0V3RG4M3/epic-game-2025/egj-gamepacks-2025/production/BOM_JLCPCB.csv

Comment | Designator | Footprint | LCSC Part #
10u | C1,C6,C20,C24 | C_0805_2012Metric | C15850
100n | C2,C9,C12,C13,C14,C15,C16,C17,C18,C19,C21,C22,C33 | C_0402_1005Metric | C1525
15p | C4,C5 | C_0402_1005Metric | C1548
4.7u | C7,C8 | C_0402_1005Metric_small_pads | C23733
4.7u | C10,C11 | C_0402_1005Metric | C23733
100n | C25,C28,C32 | C_0805_2012Metric | C49678
1u | C26,C27,C30 | C_0805_2012Metric | C28323
4.7u | C29 | C_0805_2012Metric | C1779
120n | C31 | C_0805_2012Metric | C113854
1u | C34,C35 | C_0402_1005Metric | C52923
USB_B_Micro | J1 | USB_Micro-B_Amphenol_10103594-0001LF_Horizontal | C428495
BM03B-SRSS-TB | J3 | JST_SH_BM03B-SRSS-TB_1x03-1MP_P1.00mm_Vertical | C160389
AOTA-B201610S3R3-101-T | L1 | L_pol_2016 | C42411119
0 | R2 | R_0402_1005Metric | C17168
1k | R6,R7,R9 | R_0402_1005Metric | C11702
33 | R8,R15,R16 | R_0402_1005Metric | C25105
27 | R10,R11 | R_0402_1005Metric | C25100
10k | R12 | R_0402_1005Metric | C25744
10K | R13,R14,R20,R22 | R_0402_1005Metric | C25744
47K | R17,R18 | R_0402_1005Metric | C25792
4.7K | R19,R21 | R_0402_1005Metric | C25900
100k | R23,R24 | R_0402_1005Metric | C25741
180K | R25 | R_0402_1005Metric | C25760
100K | R26 | R_0402_1005Metric | C25741
PTS810SJG250SMTRLFS | SW1,SW2 | SW_SPST_PTS810 | C221895
W25Q128JVSIQ | U1 | SOIC-8_5.3x5.3mm_P1.27mm | C97521
NCP1117-3.3_SOT223 | U3 | SOT-223-3_TabPin2 | C26537
RP2350_80QFN | U4 | RP2350-QFN-80-1EP_10x10_P0.4mm_EP3.4x3.4mm_ThermalVias | C42415655
USBLC6-2P6 | U5 | SOT-666 | C15999
TPD6E05U06RVZR | U6,U7,U8,U9,U10 | DFN-14_1.35x3.5mm_P0.5mm | C962978
VL6180V1NR/1 | U11 | LGA12R75P2X6_280X480X110 | C2655167
TXS0108EPW | U12 | TSSOP-20_4.4x6.5mm_P0.65mm | C17206
XC6206P282MR | U13 | SOT-23-3 | C347374
BNO055 | U14 | LGA-28_5.2x3.8mm_P0.5mm | C93216
TPS2116DRL | U15 | SOT-583-8 | C3235557
ABM8-272-T3 | Y1 | Crystal_SMD_3225-4Pin_3.2x2.5mm | C20625731
