0V3RG4M3/epic-game-2025/egj-gamepacks-2025/SP3012-06UTG/SP3012-06UTG.step

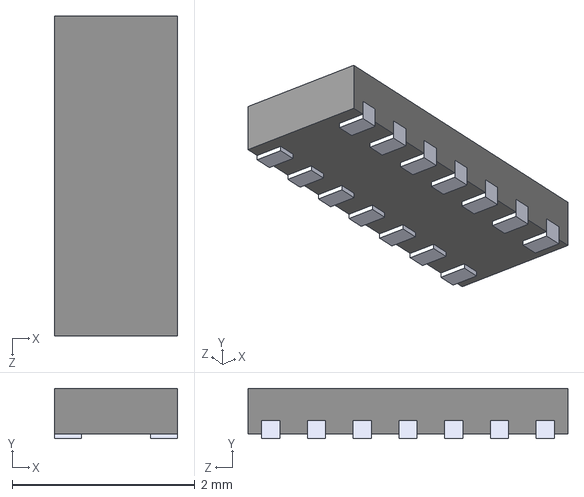
[picture p1: CAD file, 2025-04-10]
egj-gamepacks-2025/SP3012-06UTG/SP3012-06UTG.step
1.35 x 0.55 x 3.50 mm
