0V3RG4M3/epic-game-2025/egj-gamepacks-2025/VL6180XV0NR_1/VL6180XV0NR_1.step

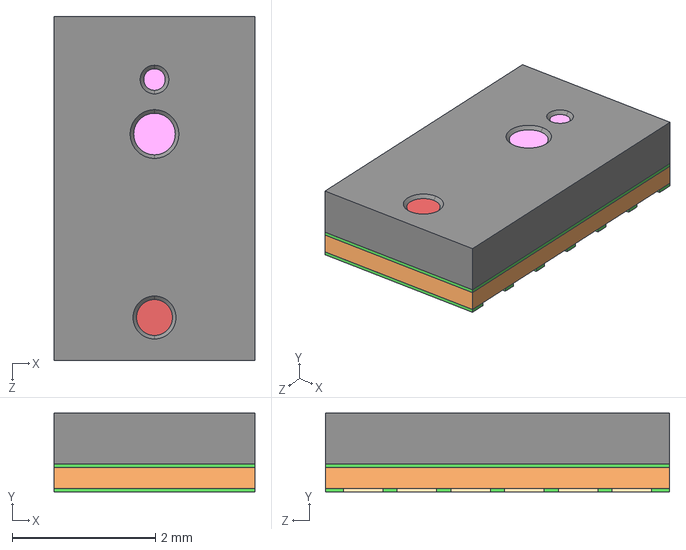
[picture p2: CAD file, 2025-04-21]
egj-gamepacks-2025/VL6180XV0NR_1/VL6180XV0NR_1.step
2.80 x 1.10 x 4.80 mm
