0V3RG4M3/epic-game-2025/egj-gamepacks-2025/egj-gamepacks-2025.kicad_pcb

## KiCad design egj-gamepacks-2025/egj-gamepacks-2025.kicad_pcb (2026-10-23)

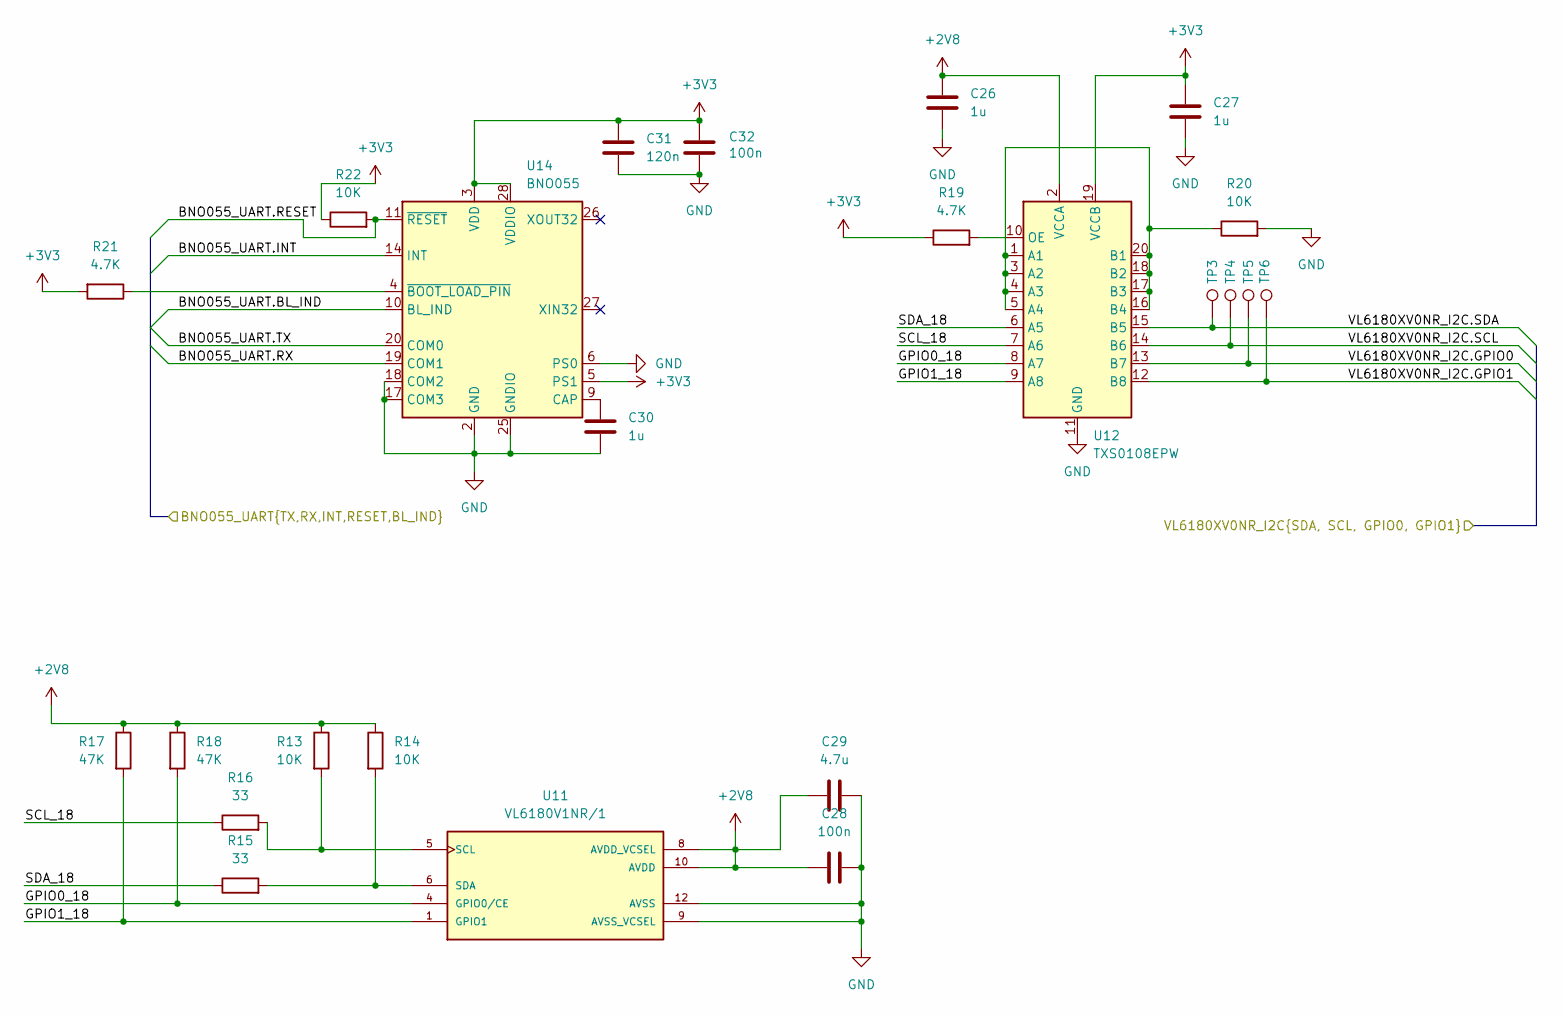
[picture p8: schematic untitled.kicad_sch]

Parts:
C26, C27, C30: 1u; C_0805_2012Metric; LCSC C28323
C28, C32: 100n; C_0805_2012Metric; LCSC C49678
C29: 4.7u; C_0805_2012Metric; LCSC C1779
C31: 120n; C_0805_2012Metric; LCSC C113854
R13, R14, R20, R22: 10K; R_0402_1005Metric; LCSC C25744
R15, R16: 33; R_0402_1005Metric; LCSC C25105
R17, R18: 47K; R_0402_1005Metric; LCSC C25792
R19, R21: 4.7K; R_0402_1005Metric; LCSC C25900
TP3, TP4, TP5, TP6: TestPoint; TestPoint_Keystone_5015_Micro_Mini; LCSC C2906768
U11: VL6180V1NR/1; LGA12R75P2X6_280X480X110; LCSC C2655167
U12: TXS0108EPW; TSSOP-20_4.4x6.5mm_P0.65mm; LCSC C17206
U14: BNO055; LGA-28_5.2x3.8mm_P0.5mm; LCSC C93216

Connections:
+2V8: C26.1, C28.1, C29.1, R13.1, R14.1, R17.1, R18.1, U11.8 (AVDD_VCSEL), U11.10 (AVDD), U12.2 (VCCA); also elsewhere on the board
+3V3: C27.1, C31.2, C32.2, R19.1, R21.2, R22.1, U12.19 (VCCB), U14.3 (VDD), U14.5 (PS1), U14.28 (VDDIO); also elsewhere on the board
/RP2350/BNO055_UART.BL_IND: U14.10 (BL_IND); also elsewhere on the board
/RP2350/BNO055_UART.INT: U14.14 (INT); also elsewhere on the board
/RP2350/BNO055_UART.RESET: R22.2, U14.11 (~RESET); also elsewhere on the board
/RP2350/BNO055_UART.RX: U14.19 (COM1); also elsewhere on the board
/RP2350/BNO055_UART.TX: U14.20 (COM0); also elsewhere on the board
/RP2350/VL6180XV0NR_I2C.GPIO0: TP5.1, U12.13 (B7); also elsewhere on the board
/RP2350/VL6180XV0NR_I2C.GPIO1: TP6.1, U12.12 (B8); also elsewhere on the board
/RP2350/VL6180XV0NR_I2C.SCL: TP4.1, U12.14 (B6); also elsewhere on the board
/RP2350/VL6180XV0NR_I2C.SDA: TP3.1, U12.15 (B5); also elsewhere on the board
/sensor_part/GPIO0_18: R18.2, U11.4 (GPIO0/CE), U12.8 (A7)
/sensor_part/GPIO1_18: R17.2, U11.1 (GPIO1), U12.9 (A8)
/sensor_part/SCL_18: R16.1, U12.7 (A6)
/sensor_part/SDA_18: R15.1, U12.6 (A5)
GND: C26.2, C27.2, C28.2, C29.2, C30.1, C31.1, C32.1, R20.2, U11.9 (AVSS_VCSEL), U11.12 (AVSS), U12.11 (GND), U14.2 (GND), U14.6 (PS0), U14.17 (COM3), U14.18 (COM2), U14.25 (GNDIO); also elsewhere on the board
unnamed: R13.2, R16.2, U11.5 (SCL)
unnamed: R14.2, R15.2, U11.6 (SDA)
unnamed: R20.1, U12.1 (A1), U12.3 (A2), U12.4 (A3), U12.5 (A4), U12.16 (B4), U12.17 (B3), U12.18 (B2), U12.20 (B1)
unnamed: R19.2, U12.10 (OE)
unnamed: C30.2, U14.9 (CAP)
unnamed: R21.1, U14.4 (~BOOT_LOAD_PIN)

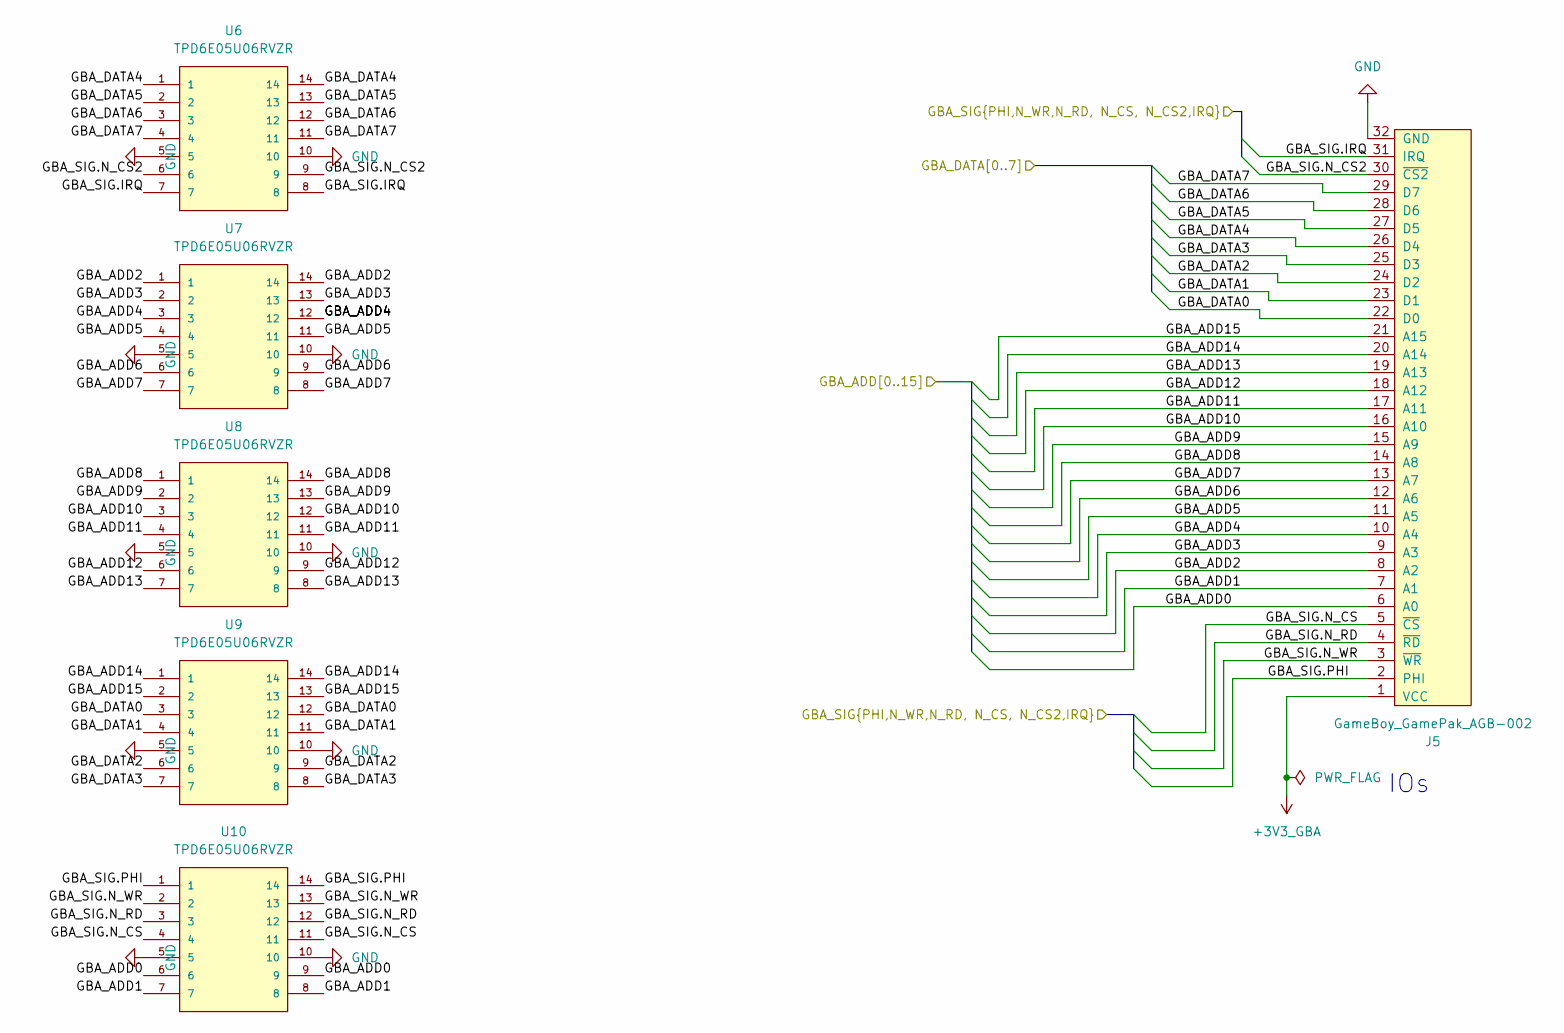
[picture p9: schematic GBA_Connector.kicad_sch]

Parts:
J5: GameBoy_GamePak_AGB-002; GameBoy_GamePak_AGB-002_P1.50mm_Edge
U6, U7, U8, U9, U10: TPD6E05U06RVZR; DFN-14_1.35x3.5mm_P0.5mm; PARTREV 02/23/17; LCSC C962978

Connections:
+3V3_GBA: J5.1 (VCC); also elsewhere on the board
/GBA_Connector/GBA_ADD0: J5.6 (A0), U10.6, U10.9; also elsewhere on the board
/GBA_Connector/GBA_ADD1: J5.7 (A1), U10.7, U10.8; also elsewhere on the board
/GBA_Connector/GBA_ADD2: J5.8 (A2), U7.1, U7.14; also elsewhere on the board
/GBA_Connector/GBA_ADD3: J5.9 (A3), U7.2, U7.13; also elsewhere on the board
/GBA_Connector/GBA_ADD4: J5.10 (A4), U7.3, U7.12; also elsewhere on the board
/GBA_Connector/GBA_ADD5: J5.11 (A5), U7.4, U7.11; also elsewhere on the board
/GBA_Connector/GBA_ADD6: J5.12 (A6), U7.6, U7.9; also elsewhere on the board
/GBA_Connector/GBA_ADD7: J5.13 (A7), U7.7, U7.8; also elsewhere on the board
/GBA_Connector/GBA_ADD8: J5.14 (A8), U8.1, U8.14; also elsewhere on the board
/GBA_Connector/GBA_ADD9: J5.15 (A9), U8.2, U8.13; also elsewhere on the board
/GBA_Connector/GBA_ADD10: J5.16 (A10), U8.3, U8.12; also elsewhere on the board
/GBA_Connector/GBA_ADD11: J5.17 (A11), U8.4, U8.11; also elsewhere on the board
/GBA_Connector/GBA_ADD12: J5.18 (A12), U8.6, U8.9; also elsewhere on the board
/GBA_Connector/GBA_ADD13: J5.19 (A13), U8.7, U8.8; also elsewhere on the board
/GBA_Connector/GBA_ADD14: J5.20 (A14), U9.1, U9.14; also elsewhere on the board
/GBA_Connector/GBA_ADD15: J5.21 (A15), U9.2, U9.13; also elsewhere on the board
/GBA_Connector/GBA_DATA0: J5.22 (D0), U9.3, U9.12; also elsewhere on the board
/GBA_Connector/GBA_DATA1: J5.23 (D1), U9.4, U9.11; also elsewhere on the board
/GBA_Connector/GBA_DATA2: J5.24 (D2), U9.6, U9.9; also elsewhere on the board
/GBA_Connector/GBA_DATA3: J5.25 (D3), U9.7, U9.8; also elsewhere on the board
/GBA_Connector/GBA_DATA4: J5.26 (D4), U6.1, U6.14; also elsewhere on the board
/GBA_Connector/GBA_DATA5: J5.27 (D5), U6.2, U6.13; also elsewhere on the board
/GBA_Connector/GBA_DATA6: J5.28 (D6), U6.3, U6.12; also elsewhere on the board
/GBA_Connector/GBA_DATA7: J5.29 (D7), U6.4, U6.11; also elsewhere on the board
/GBA_Connector/GBA_SIG.IRQ: J5.31 (IRQ), U6.7, U6.8; also elsewhere on the board
/GBA_Connector/GBA_SIG.N_CS: J5.5 (~CS), U10.4, U10.11; also elsewhere on the board
/GBA_Connector/GBA_SIG.N_CS2: J5.30 (~CS2), U6.6, U6.9; also elsewhere on the board
/GBA_Connector/GBA_SIG.N_RD: J5.4 (~RD), U10.3, U10.12; also elsewhere on the board
/GBA_Connector/GBA_SIG.N_WR: J5.3 (~WR), U10.2, U10.13; also elsewhere on the board
/GBA_Connector/GBA_SIG.PHI: J5.2 (PHI), U10.1, U10.14; also elsewhere on the board
GND: J5.32 (GND), U6.5, U6.10, U7.5, U7.10, U8.5, U8.10, U9.5, U9.10, U10.5, U10.10; also elsewhere on the board

Notes on the sheet:
IOs

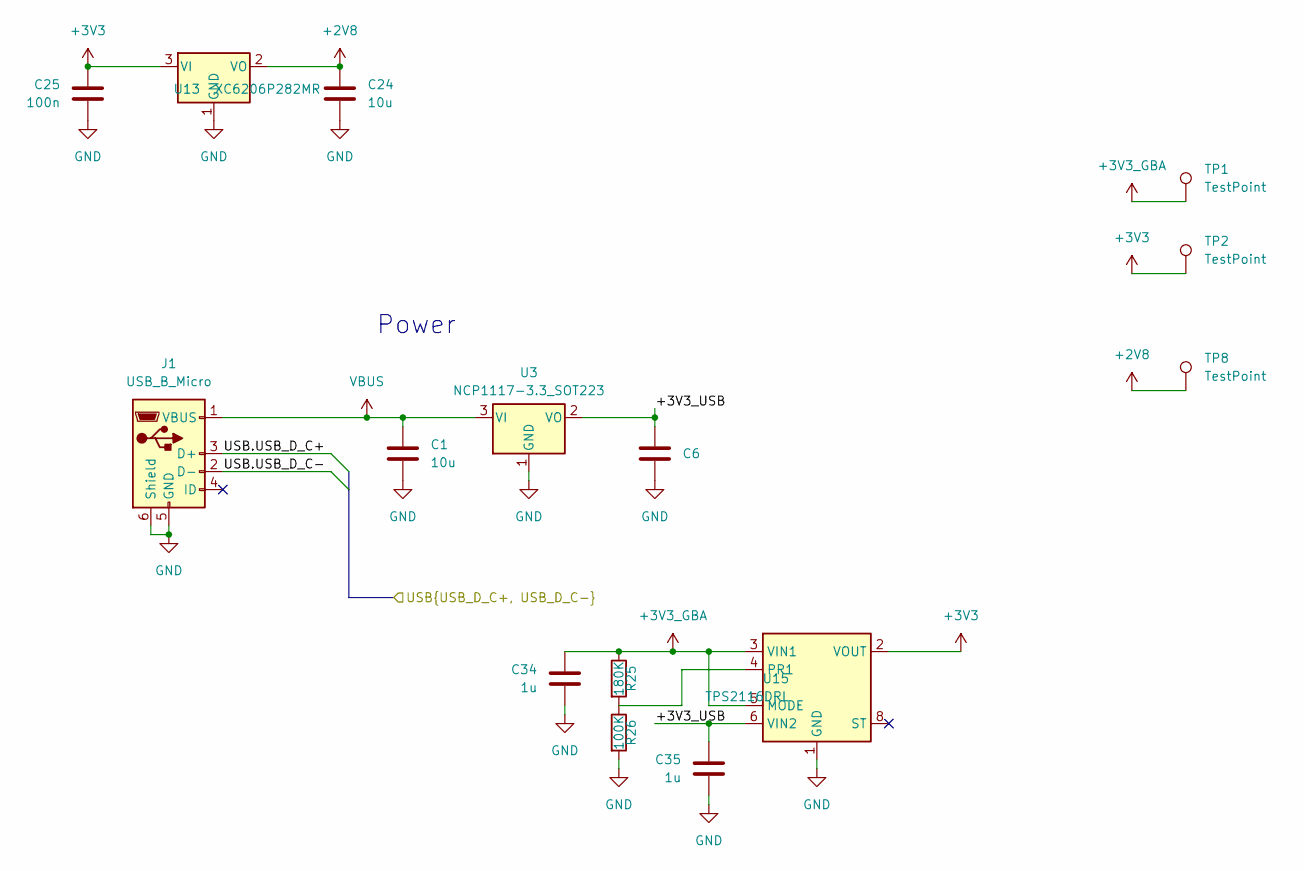
[picture p10: schematic power.kicad_sch]

Parts:
C1, C6, C24: 10u; C_0805_2012Metric; LCSC C15850
C25: 100n; C_0805_2012Metric; LCSC C49678
C34, C35: 1u; C_0402_1005Metric; LCSC C52923
J1: USB_B_Micro; USB_Micro-B_Amphenol_10103594-0001LF_Horizontal; LCSC C428495
R25: 180K; R_0402_1005Metric; LCSC C25760
R26: 100K; R_0402_1005Metric; LCSC C25741
TP1, TP2, TP8: TestPoint; TestPoint_Keystone_5015_Micro_Mini; LCSC C2906768
U3: NCP1117-3.3_SOT223; SOT-223-3_TabPin2; LCSC C26537
U13: XC6206P282MR; SOT-23-3; LCSC C347374
U15: TPS2116DRL; SOT-583-8; LCSC C3235557

Connections:
+2V8: C24.1, TP8.1, U13.2 (VO); also elsewhere on the board
+3V3: C25.1, TP2.1, U13.3 (VI), U15.2 (VOUT), U15.7 (VOUT); also elsewhere on the board
+3V3_GBA: C34.1, R25.1, TP1.1, U15.3 (VIN1), U15.5 (MODE); also elsewhere on the board
/Power/+3V3_USB: C6.1, C35.1, U3.2 (VO), U15.6 (VIN2)
/Power/USB.USB_D_C+: J1.3 (D+); also elsewhere on the board
/Power/USB.USB_D_C-: J1.2 (D-); also elsewhere on the board
GND: C1.2, C6.2, C24.2, C25.2, C34.2, C35.2, J1.5 (GND), J1.6 (Shield), R26.2, U3.1 (GND), U13.1 (GND), U15.1 (GND); also elsewhere on the board
unnamed: R25.2, R26.1, U15.4 (PR1)
VBUS: C1.1, J1.1 (VBUS), U3.3 (VI); also elsewhere on the board

Notes on the sheet:
Power

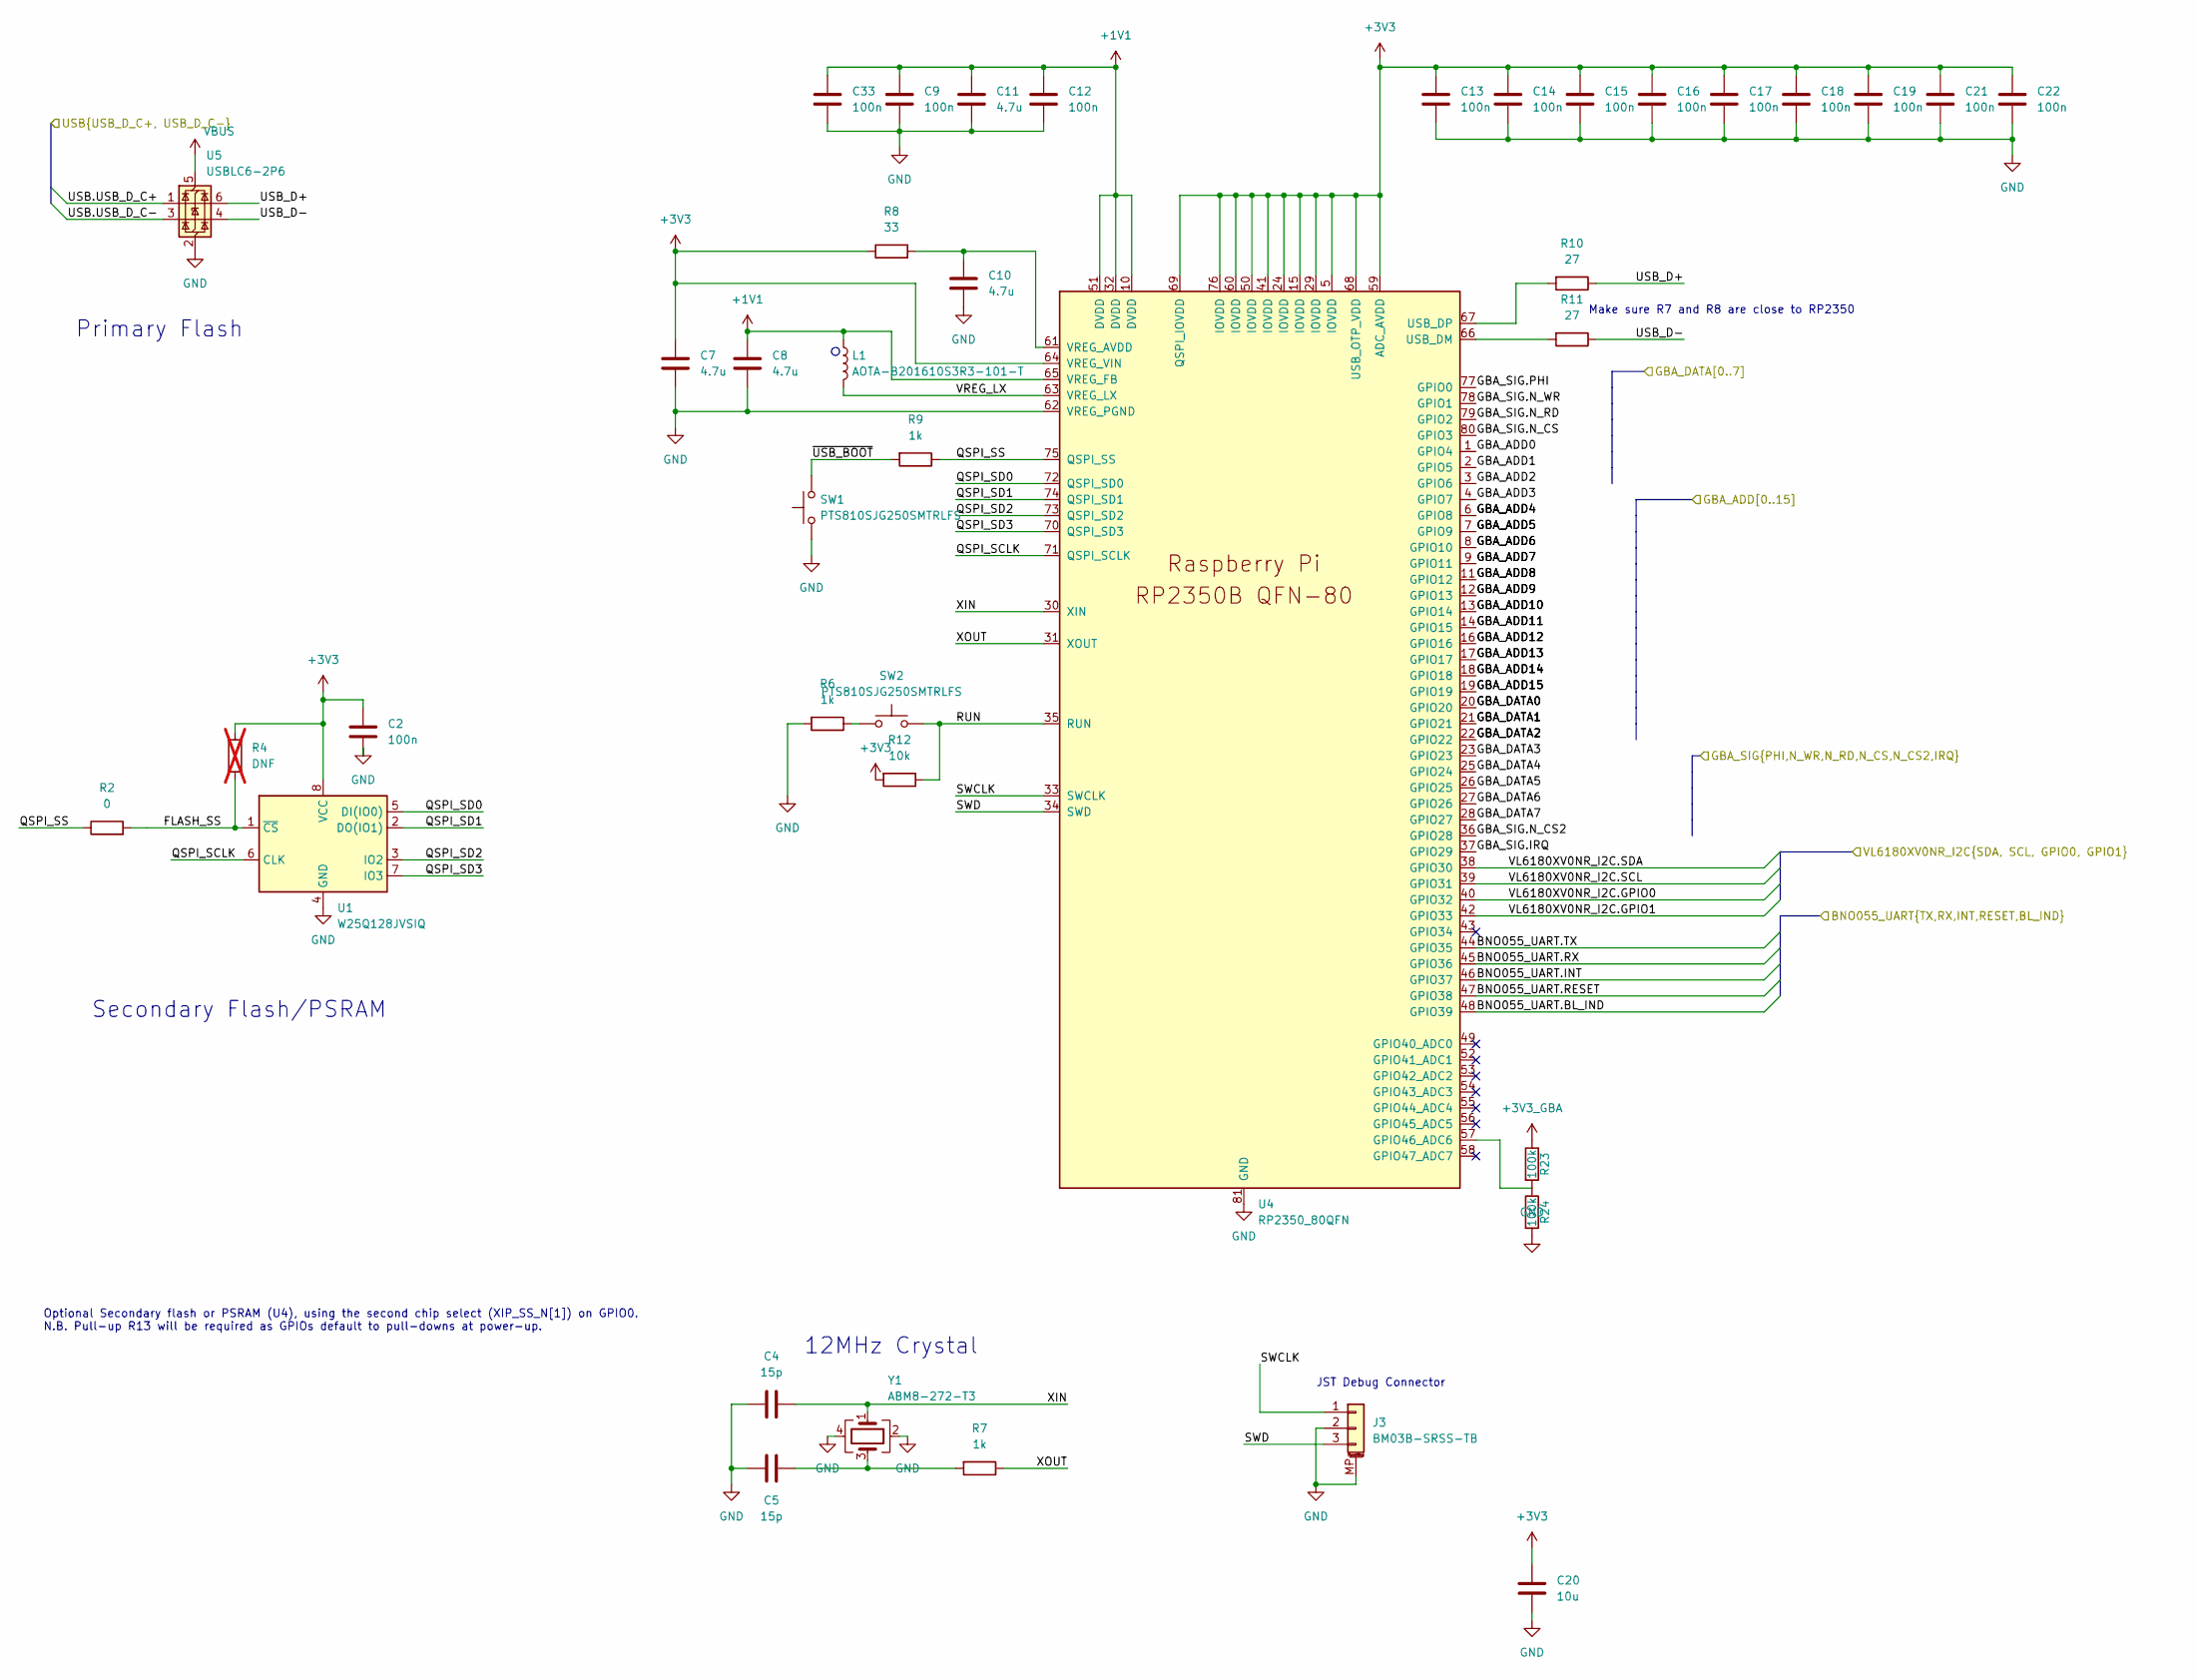
[picture p11: schematic RP2350.kicad_sch]

Parts:
C2, C9, C12, C13, C14, C15, C16, C17, C18, C19, C21, C22, C33: 100n; C_0402_1005Metric; LCSC C1525
C4, C5: 15p; C_0402_1005Metric; LCSC C1548
C7, C8: 4.7u; C_0402_1005Metric_small_pads; LCSC C23733
C10, C11: 4.7u; C_0402_1005Metric; LCSC C23733
C20: 10u; C_0805_2012Metric; LCSC C15850
J3: BM03B-SRSS-TB; JST_SH_BM03B-SRSS-TB_1x03-1MP_P1.00mm_Vertical; LCSC C160389
L1: AOTA-B201610S3R3-101-T; L_pol_2016; LCSC C42411119
R2: 0; R_0402_1005Metric; LCSC C17168
R4: DNF; R_0402_1005Metric; not fitted
R6, R7, R9: 1k; R_0402_1005Metric; LCSC C11702
R8: 33; R_0402_1005Metric; LCSC C25105
R10, R11: 27; R_0402_1005Metric; LCSC C25100
R12: 10k; R_0402_1005Metric; LCSC C25744
R23, R24: 100k; R_0402_1005Metric; LCSC C25741
SW1, SW2: PTS810SJG250SMTRLFS; SW_SPST_PTS810; LCSC C221895
U1: W25Q128JVSIQ; SOIC-8_5.3x5.3mm_P1.27mm; LCSC C97521
U4: RP2350_80QFN; RP2350-QFN-80-1EP_10x10_P0.4mm_EP3.4x3.4mm_ThermalVias; LCSC C42415655
U5: USBLC6-2P6; SOT-666; LCSC C15999
Y1: ABM8-272-T3; Crystal_SMD_3225-4Pin_3.2x2.5mm; LCSC C20625731

Connections:
+1V1: C8.1, C9.1, C11.1, C12.1, C33.1, L1.1, U4.10 (DVDD), U4.32 (DVDD), U4.51 (DVDD), U4.65 (VREG_FB)
+3V3: C2.1, C7.1, C13.1, C14.1, C15.1, C16.1, C17.1, C18.1, C19.1, C20.1, C21.1, C22.1, R4.1, R8.1, R12.2, U1.8 (VCC), U4.5 (IOVDD), U4.15 (IOVDD), U4.24 (IOVDD), U4.29 (IOVDD), U4.41 (IOVDD), U4.50 (IOVDD), U4.59 (ADC_AVDD), U4.60 (IOVDD), U4.64 (VREG_VIN), U4.68 (USB_OTP_VDD), U4.69 (QSPI_IOVDD), U4.76 (IOVDD); also elsewhere on the board
+3V3_GBA: R23.1; also elsewhere on the board
/GBA_Connector/GBA_ADD0: U4.1 (GPIO4); also elsewhere on the board
/GBA_Connector/GBA_ADD1: U4.2 (GPIO5); also elsewhere on the board
/GBA_Connector/GBA_ADD2: U4.3 (GPIO6); also elsewhere on the board
/GBA_Connector/GBA_ADD3: U4.4 (GPIO7); also elsewhere on the board
/GBA_Connector/GBA_ADD4: U4.6 (GPIO8); also elsewhere on the board
/GBA_Connector/GBA_ADD5: U4.7 (GPIO9); also elsewhere on the board
/GBA_Connector/GBA_ADD6: U4.8 (GPIO10); also elsewhere on the board
/GBA_Connector/GBA_ADD7: U4.9 (GPIO11); also elsewhere on the board
/GBA_Connector/GBA_ADD8: U4.11 (GPIO12); also elsewhere on the board
/GBA_Connector/GBA_ADD9: U4.12 (GPIO13); also elsewhere on the board
/GBA_Connector/GBA_ADD10: U4.13 (GPIO14); also elsewhere on the board
/GBA_Connector/GBA_ADD11: U4.14 (GPIO15); also elsewhere on the board
/GBA_Connector/GBA_ADD12: U4.16 (GPIO16); also elsewhere on the board
/GBA_Connector/GBA_ADD13: U4.17 (GPIO17); also elsewhere on the board
/GBA_Connector/GBA_ADD14: U4.18 (GPIO18); also elsewhere on the board
/GBA_Connector/GBA_ADD15: U4.19 (GPIO19); also elsewhere on the board
/GBA_Connector/GBA_DATA0: U4.20 (GPIO20); also elsewhere on the board
/GBA_Connector/GBA_DATA1: U4.21 (GPIO21); also elsewhere on the board
/GBA_Connector/GBA_DATA2: U4.22 (GPIO22); also elsewhere on the board
/GBA_Connector/GBA_DATA3: U4.23 (GPIO23); also elsewhere on the board
/GBA_Connector/GBA_DATA4: U4.25 (GPIO24); also elsewhere on the board
/GBA_Connector/GBA_DATA5: U4.26 (GPIO25); also elsewhere on the board
/GBA_Connector/GBA_DATA6: U4.27 (GPIO26); also elsewhere on the board
/GBA_Connector/GBA_DATA7: U4.28 (GPIO27); also elsewhere on the board
/GBA_Connector/GBA_SIG.IRQ: U4.37 (GPIO29); also elsewhere on the board
/GBA_Connector/GBA_SIG.N_CS: U4.80 (GPIO3); also elsewhere on the board
/GBA_Connector/GBA_SIG.N_CS2: U4.36 (GPIO28); also elsewhere on the board
/GBA_Connector/GBA_SIG.N_RD: U4.79 (GPIO2); also elsewhere on the board
/GBA_Connector/GBA_SIG.N_WR: U4.78 (GPIO1); also elsewhere on the board
/GBA_Connector/GBA_SIG.PHI: U4.77 (GPIO0); also elsewhere on the board
/Power/USB.USB_D_C+: U5.1 (I/O1); also elsewhere on the board
/Power/USB.USB_D_C-: U5.3 (I/O2); also elsewhere on the board
/RP2350/BNO055_UART.BL_IND: U4.48 (GPIO39); also elsewhere on the board
/RP2350/BNO055_UART.INT: U4.46 (GPIO37); also elsewhere on the board
/RP2350/BNO055_UART.RESET: U4.47 (GPIO38); also elsewhere on the board
/RP2350/BNO055_UART.RX: U4.45 (GPIO36); also elsewhere on the board
/RP2350/BNO055_UART.TX: U4.44 (GPIO35); also elsewhere on the board
/RP2350/FLASH_SS: R2.2, R4.2, U1.1 (~CS)
/RP2350/QSPI_SCLK: U1.6 (CLK), U4.71 (QSPI_SCLK)
/RP2350/QSPI_SD0: U1.5 (DI(IO0)), U4.72 (QSPI_SD0)
/RP2350/QSPI_SD1: U1.2 (DO(IO1)), U4.74 (QSPI_SD1)
/RP2350/QSPI_SD2: U1.3 (IO2), U4.73 (QSPI_SD2)
/RP2350/QSPI_SD3: U1.7 (IO3), U4.70 (QSPI_SD3)
/RP2350/QSPI_SS: R2.1, R9.1, U4.75 (QSPI_SS)
/RP2350/RUN: R12.1, SW2.2, U4.35 (RUN)
/RP2350/SWCLK: J3.1, U4.33 (SWCLK)
/RP2350/SWD: J3.3, U4.34 (SWD)
/RP2350/USB_D+: R10.1, U5.6 (I/O1)
/RP2350/USB_D-: R11.1, U5.4 (I/O2)
/RP2350/VL6180XV0NR_I2C.GPIO0: U4.40 (GPIO32); also elsewhere on the board
/RP2350/VL6180XV0NR_I2C.GPIO1: U4.42 (GPIO33); also elsewhere on the board
/RP2350/VL6180XV0NR_I2C.SCL: U4.39 (GPIO31); also elsewhere on the board
/RP2350/VL6180XV0NR_I2C.SDA: U4.38 (GPIO30); also elsewhere on the board
/RP2350/VREG_LX: L1.2, U4.63 (VREG_LX)
/RP2350/XIN: C4.1, U4.30 (XIN), Y1.1
/RP2350/XOUT: R7.1, U4.31 (XOUT)
/RP2350/~USB_BOOT: R9.2, SW1.2
GND: C2.2, C4.2, C5.2, C7.2, C8.2, C9.2, C10.2, C11.2, C12.2, C13.2, C14.2, C15.2, C16.2, C17.2, C18.2, C19.2, C20.2, C21.2, C22.2, C33.2, J3.2, J3.MP (MountPin), R6.2, R24.2, SW1.1, U1.4 (GND), U4.62 (VREG_PGND), U4.81 (GND), U5.2 (GND), Y1.2, Y1.4; also elsewhere on the board
unnamed: C5.1, R7.2, Y1.3
unnamed: R6.1, SW2.1
unnamed: R23.2, R24.1, U4.57 (GPIO46_ADC6)
unnamed: R11.2, U4.66 (USB_DM)
unnamed: R10.2, U4.67 (USB_DP)
unnamed: C10.1, R8.2, U4.61 (VREG_AVDD)
VBUS: U5.5 (VBUS); also elsewhere on the board

Notes on the sheet:
Make sure R7 and R8 are close to RP2350
Primary Flash
JST Debug Connector
12MHz Crystal
Secondary Flash/PSRAM
Optional Secondary flash or PSRAM (U4), using the second chip select (XIP_SS_N[1]) on GPIO0. N.B. Pull-up R13 will be required as GPIOs default to pull-downs at power-up.

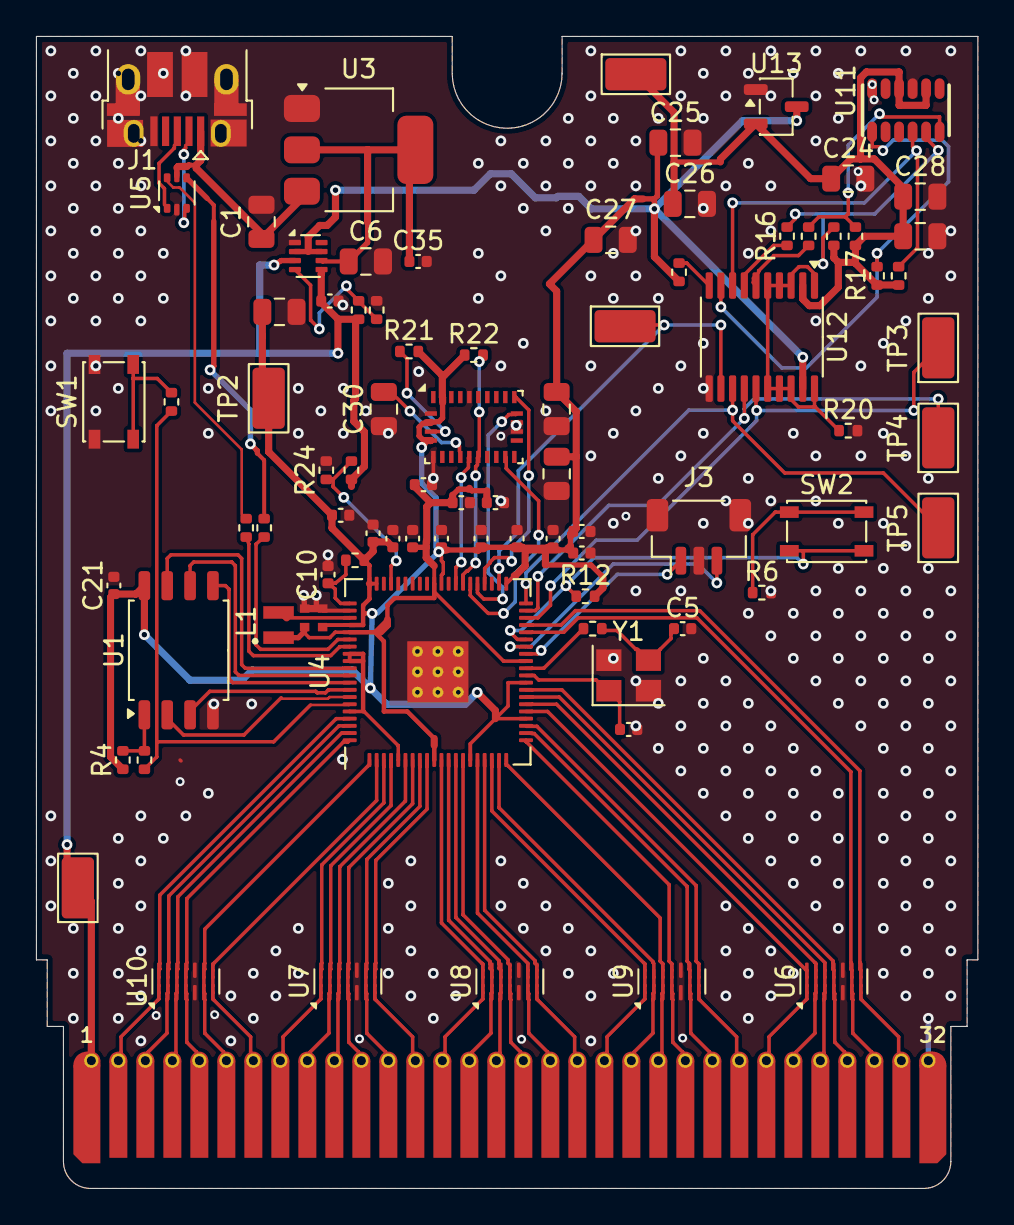
[picture p12: board egj-gamepacks-2025.kicad_pcb from above]

Board: 2 copper layers, 52.3 x 64.0 mm, 84 parts (0 on the bottom side), 81 nets.
