0V3RG4M3/epic-game-2025/(commit log)

2025-04-03 PCB Design
    [egj-gamepacks-2025.kicad_pcb, egj-gamepacks-2025.kicad_sch, egj-gamepacks-2025.sch]
2025-04-10 ADD: new design
    [SP3012-06UTG.step, egj-gamepacks-2025.kicad_pcb, egj-gamepacks-2025.kicad_sch, egj-gamepacks-2025.sch]
2025-04-21 add new schemas
    [GBA_Connector.kicad_sch, RP2350.kicad_sch, VL6180XV0NR_1.step, egj-gamepacks-2025.kicad_pcb, egj-gamepacks-2025.kicad_sch, power.kicad_sch, untitled.kicad_sch]
2026-10-22 UPDATE: sync local schematic and board work
2026-10-22 FIX: schematic fixes, JLCPCB parts with LCSC numbers and GBA bus GPIO remap
2026-10-22 ADD: board placement and full two-layer routing with JLCPCB design rules
2026-10-23 FIX: RP2350 regulator inductor, I2C pull-ups, DVDD decoupling and drop second flash option
2026-10-23 ADD: TPS2116 power path so the cartridge runs from console, USB or both
2026-10-23 UPDATE: rework RP2350 regulator layout, power path routing, finger tab clearance and silkscreen
2026-10-23 ADD: JLCPCB production files (gerbers, drill, BOM, CPL)
